elegantmonark/stratologger/mechanical/renders/README.md

# Enclosure renders

No enclosure render or physical print is published at this revision. Renders should be
exported only after the nominal parameters in `enclosure.scad` have been compared with
the measured modules and approved PCB assembly.
