elegantmonark/stratologger/pcb/SL-1/review/original-routing.png

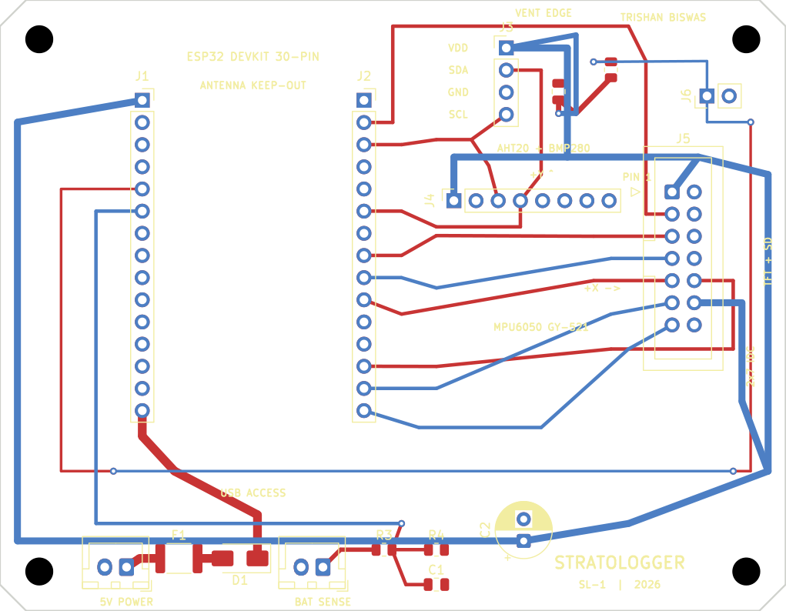
pcb/SL-1/review/original-routing.png
