elegantmonark/stratologger/electrical/bom.csv

Reference | Quantity | Part | Specification / note
U1 | 1 | ESP32 DevKit V1 | 30-pin ESP32-WROOM-32 board; confirm 25.4 mm row spacing
DISP1 | 1 | ST7789V TFT module | 2.4 inch 240x320 SPI 14-pin with onboard microSD socket
SENS1 | 1 | AHT20 + BMP280 combo board | 3.3 V I2C; VDD SDA GND SCL header order
IMU1 | 1 | MPU6050 GY-521 | 3.3 V supply; VCC GND SCL SDA XDA XCL AD0 INT header order
SW1 | 1 | Enclosure-mounted momentary pushbutton | Normally open; connects through J6
R2 | 1 | Button pull-up | 10 kohm 1 percent 0805
R3-R4 | 2 | Battery divider resistors | 100 kohm 1 percent 0805
C1 | 1 | ADC filter capacitor | 100 nF X7R 0805
C2 | 1 | 3.3 V bulk capacitor | 100 uF 6.3 V low-ESR radial; 6.3 mm body 2.5 mm pitch
C3 | 1 | Environmental-sensor decoupling | 100 nF X7R 0805
F1 | 1 | Resettable fuse | 750 mA 1812 PTC
D1 | 1 | Schottky diode | SS34 SMA
J1-J2 | 2 | ESP32 sockets | 1x15 2.54 mm female headers; 25.4 mm row spacing
J3 | 1 | Environmental sensor connection | 1x4 2.54 mm male header
J4 | 1 | MPU6050 socket | 1x8 2.54 mm female header
J5 | 1 | Remote display connector | Keyed 2x7 2.54 mm vertical IDC box header
J6 | 1 | Remote button connector | 1x2 2.54 mm male header
J7-J8 | 2 | Power and battery-sense connectors | JST-XH 2-pin vertical; use matching pigtails (not Dupont)
PS1 | 1 | 5 V boost converter | Regulated 5 V output; at least 1 A peak
BAT1 | 1 | Protected Li-ion or LiPo cell | Cell and protection must match the charger
CHG1 | 1 | Single-cell charger/protection module | Must match cell chemistry and charging source
SW2 | 1 | Power switch | Rated above converter input peak current
PCB1 | 1 | Stratologger SL-1 PCB | 90 x 70 mm; 2-layer 1.6 mm FR-4 1 oz copper
CABLE1 | 1 | Display harness | 2x7 IDC female at PCB; 1x14 female and 1x4 male at TFT; 100 mm maximum
WIRE | 1 lot | Hook-up wire | Stranded wire for power and enclosure-mounted button
HW | 1 lot | M3 fasteners | Four PCB standoffs; nylon or metal with washers
