elegantmonark/stratologger/results/log-validation/fault_matrix.csv

case | expectation_met | rows | error_count | categories
clean_5_minutes | True | 600 | 0
changed_measurement | True | 600 | 1 | checksum=1
dropped_packet | True | 599 | 2 | packet_gap=1; timing_gap=1
duplicate_packet | True | 601 | 2 | packet_order=1; timestamp_order=1
reordered_packets | True | 600 | 6 | packet_gap=2; timing_gap=2; packet_order=1; timestamp_order=1
frozen_clock | True | 600 | 2 | timestamp_order=1; timing_gap=1
acquisition_stall | True | 600 | 1 | timing_gap=1
partial_final_row | True | 600 | 2 | truncated=1; malformed=1
missing_final_newline | True | 600 | 1 | truncated=1
sensor_nan_valid_checksum | True | 600 | 1 | nonfinite=1
humidity_out_of_range | True | 600 | 1 | range=1
packet_integer_overflow | True | 600 | 3 | malformed=1; packet_gap=1; timing_gap=1
infinite_reading | True | 600 | 2 | checksum=1; nonfinite=1
scaled_integer_overflow | True | 600 | 3 | malformed=1; packet_gap=1; timing_gap=1
header_only | True | 0 | 1 | empty=1
wrong_header | True | 600 | 1 | header=1
invalid_encoding | True | 573 | 1 | malformed=1
counter_rollovers | True | 600 | 0
xor_cancellation | True | 600 | 0
