elegantmonark/stratologger/pcb/SL-1/Stratologger_SL1.kicad_pcb

## KiCad design pcb/SL-1/Stratologger_SL1.kicad_pcb (2026-11-10)

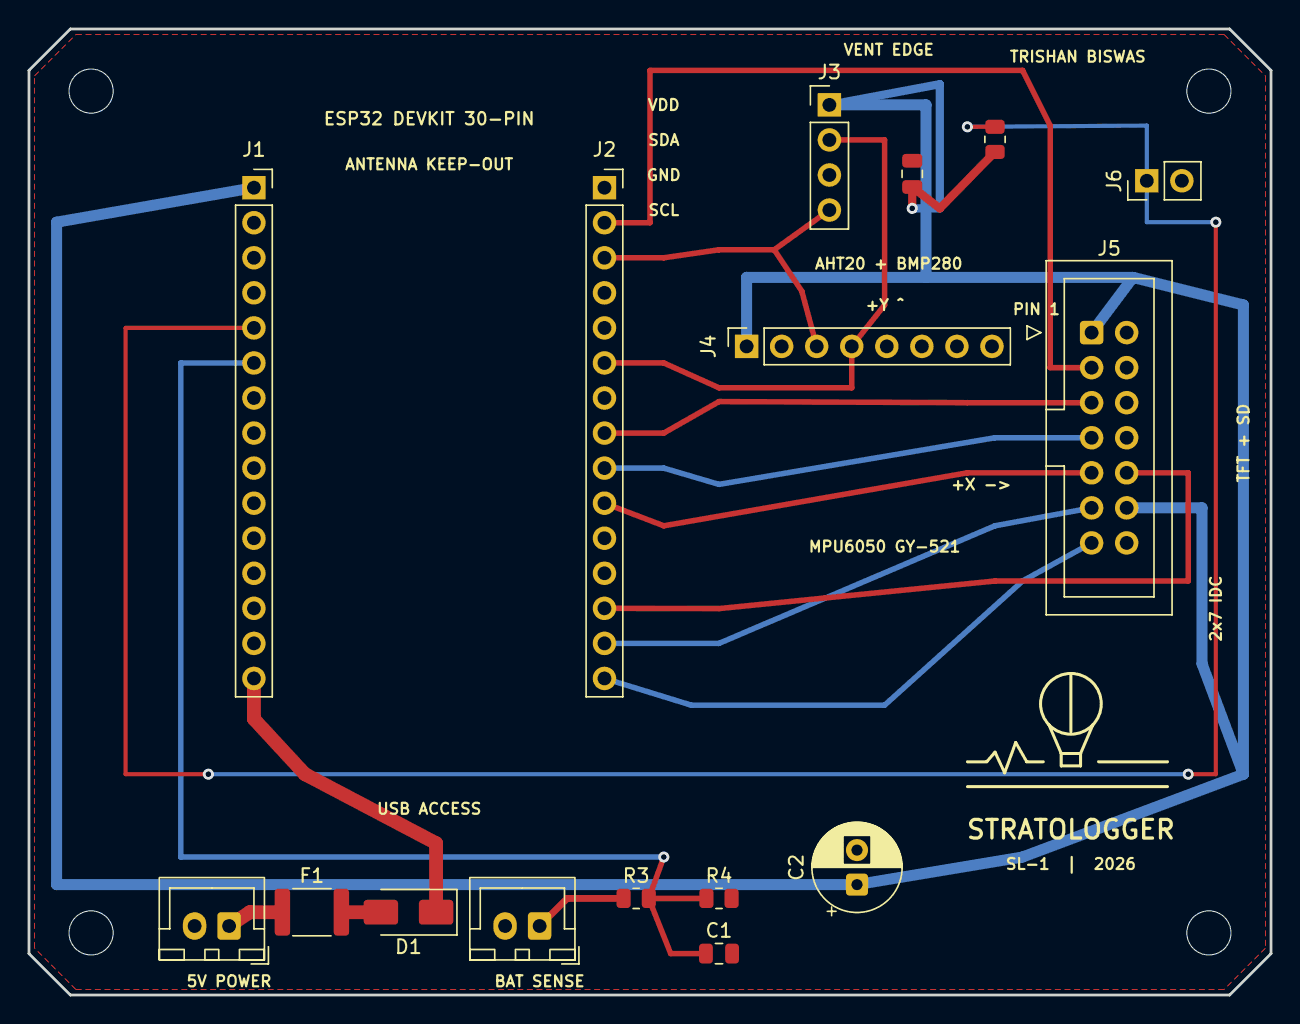
[picture p7: board Stratologger_SL1.kicad_pcb from above]

Board: 2 copper layers, 90.0 x 70.0 mm, 20 parts (0 on the bottom side), 17 nets.

Parts:
C1, C3: 100nF; C_0805_2012Metric
C2: 100uF 6.3V; CP_Radial_D6.3mm_P2.50mm
D1: SS34; D_SMA
F1: 0.75A PTC; Fuse_1812_4532Metric
H1, H2, H3, H4: M3; MountingHole_3.2mm_M3
J1: ESP32_LEFT; PinSocket_1x15_P2.54mm_Vertical
J2: ESP32_RIGHT; PinSocket_1x15_P2.54mm_Vertical
J3: AHT20_BMP280; PinHeader_1x04_P2.54mm_Vertical
J4: MPU6050_GY521; PinSocket_1x08_P2.54mm_Vertical
J5: REMOTE_TFT_SD; IDC-Header_2x07_P2.54mm_Vertical
J6: REMOTE_BUTTON; PinHeader_1x02_P2.54mm_Vertical
J7: REGULATED_5V_IN; JST_XH_B2B-XH-A_1x02_P2.50mm_Vertical
J8: BATTERY_SENSE_ONLY; JST_XH_B2B-XH-A_1x02_P2.50mm_Vertical
R2: 10k BUTTON PULLUP; R_0805_2012Metric
R3, R4: 100k 1%; R_0805_2012Metric

Connections:
+3V3: C2.1, C3.1, J1.1, J3.1, J4.1, J5.1, J5.12, R2.1
+5V_EXT: F1.1, J7.1
+5V_FUSED: D1.2, F1.2
BATTERY_SENSE: C1.1, J1.6, R3.2, R4.1
BAT_RAW: J8.1, R3.1
GND: C1.2, C2.2, C3.2, J1.14, J2.1, J2.7, J3.3, J4.2, J5.2, J5.4, J5.6, J5.8, J5.14, J6.2, J7.2, J8.2, R4.2
I2C_SCL: J2.3, J3.4, J4.3
I2C_SDA: J2.6, J3.2, J4.4
SCREEN_BUTTON: J1.5, J6.1, R2.2
SD_CS: J2.10, J5.9
SPI_MISO: J2.8, J5.5
SPI_MOSI: J2.2, J5.3
SPI_SCK: J2.9, J5.7
TFT_CS: J2.15, J5.13
TFT_DC: J2.14, J5.11
TFT_RST: J2.13, J5.10
VIN_5V: D1.1, J1.15
