elegantmonark/stratologger/(commit log)

2026-10-18 Initial telemetry payload design and firmware
    [bom.csv, enclosure.scad, format-example.csv, netlist.csv]
2026-11-10 Add SL-1 PCB design and telemetry validation
    [Stratologger_SL1-B_Cu.gbl, Stratologger_SL1-B_Mask.gbs, Stratologger_SL1-B_Silkscreen.gbo, Stratologger_SL1-Edge_Cuts.gm1, Stratologger_SL1-F_Cu.gtl, Stratologger_SL1-F_Mask.gts, Stratologger_SL1-F_Silkscreen.gto, Stratologger_SL1-NPTH.drl]
2026-11-10 Restructure README and add SL-1 PCB screenshots
    [Stratologger_SL1.kicad_pcb]
